OS-Q/B14A/README.md

# [B14A](https://github.com/OS-Q/B14A)

[B14A](https://github.com/OS-Q/B14A) 标准硬件模组应用 [P14](https://github.com/OS-Q/P14) 进行开发

### [Q = (OpenSource & OperatingSystem) ](http://www.OS-Q.com)
