OS-Q/B14A/module/B41A.kicad_pcb

## KiCad design module/B41A.kicad_pcb (2021-03-03)

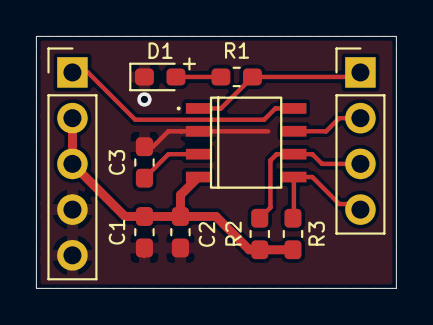
[picture p1: board B41A.kicad_pcb from above]

Board: 2 copper layers, 20.0 x 14.0 mm, 10 parts (0 on the bottom side), 9 nets.

Parts:
C1, C3: 1uF; C_0603_1608Metric_Pad1.05x0.95mm_HandSolder
C2: 100nF; C_0603_1608Metric_Pad1.05x0.95mm_HandSolder
D1: LED; LED_0603_1608Metric_Pad1.05x0.95mm_HandSolder
J1: Conn_01x05_Male; PinHeader_1x05_P2.54mm_Vertical
J2: Conn_01x04_Male; PinHeader_1x04_P2.54mm_Vertical
R1: 2K; R_0603_1608Metric_Pad1.05x0.95mm_HandSolder
R2, R3: 4.7K; R_0603_1608Metric_Pad1.05x0.95mm_HandSolder
U1: STM8S001J3M; SO8N

Connections:
/SWIM: J1.1, U1.8
/VCAP: C3.1, U1.3
/VDD: C1.1, C2.1, J1.2, J1.3, R2.1, R3.2, U1.4
GND: C1.2, C2.2, C3.2, D1.1, J1.4, J1.5, U1.2
unnamed: D1.2, R1.2
unnamed: J2.1, R1.1, U1.1
unnamed: J2.2, U1.7
unnamed: J2.3, R2.2, U1.6
unnamed: J2.4, R3.1, U1.5
