OS-Q/B14A/demo/demo14A.kicad_pcb

## KiCad design demo/demo14A.kicad_pcb (2021-03-03)

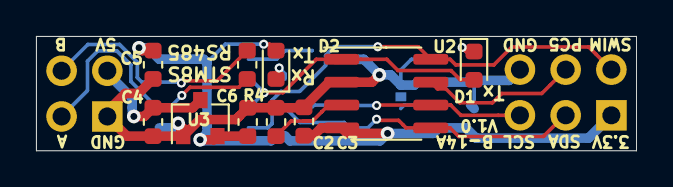
[picture p2: board demo14A.kicad_pcb from above]

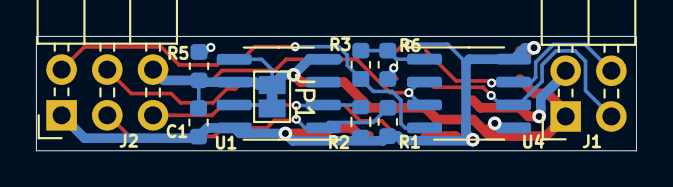
[picture p3: board demo14A.kicad_pcb from below]

Board: 2 copper layers, 33.3 x 6.3 mm, 21 parts (11 on the bottom side), 15 nets.

Parts:
C1, C3, C5: 100nF; C_0603_1608Metric
C2, C4, C6: 1uF; C_0603_1608Metric
D1: LED red; LED_0603_1608Metric
D2: LED green; LED_0603_1608Metric
J1: Conn_02x02_Odd_Even; PinHeader_2x02_P2.54mm_Horizontal
J2: Conn_02x03_Counter_Clockwise; PinHeader_2x03_P2.54mm_Horizontal
JP1: A0; SolderJumper-2_P1.3mm_Bridged_Pad1.0x1.5mm
R1, R2, R3, R5, R6: 4k7; R_0603_1608Metric
R4: 120R; R_0603_1608Metric
U1: DS1621S; SOIC-8_3.9x4.9mm_P1.27mm
U2: STM8S001J3M; SOIC-8_3.9x4.9mm_P1.27mm
U3: XC6206P332MR; SOT-23
U4: SP3485CN; SOIC-8_3.9x4.9mm_P1.27mm

Connections:
+3V3: C1.2, C3.2, C5.2, C6.2, D2.2, J2.1, R1.1, R2.1, U1.8, U2.4, U3.2, U4.8
+5V: C4.2, J1.2, U3.3
/A: J1.3, R4.1, U4.6
/B: J1.4, R4.2, U4.7
/DIR.RX: D1.2, U2.1, U4.2, U4.3
/PC5: J2.4, U2.7
/SCL: J2.5, R2.2, U1.2, U2.6
/SDA: J2.3, R1.2, U1.1, U2.5
/SWIM.TX: J2.2, R3.1, U2.8, U4.4
GND: C1.1, C2.1, C3.1, C4.1, C5.1, C6.1, J1.1, J2.6, JP1.1, R5.2, U1.4, U1.5, U1.6, U2.2, U3.1, U4.5
unnamed: C2.2, U2.3
unnamed: D1.1, R5.1
unnamed: D2.1, R6.1
unnamed: JP1.2, U1.7
unnamed: R3.2, R6.2, U4.1
